TaDuc-TD/STM32KIT/Potentiometer_Bourns_3296W_Vertical.STEP

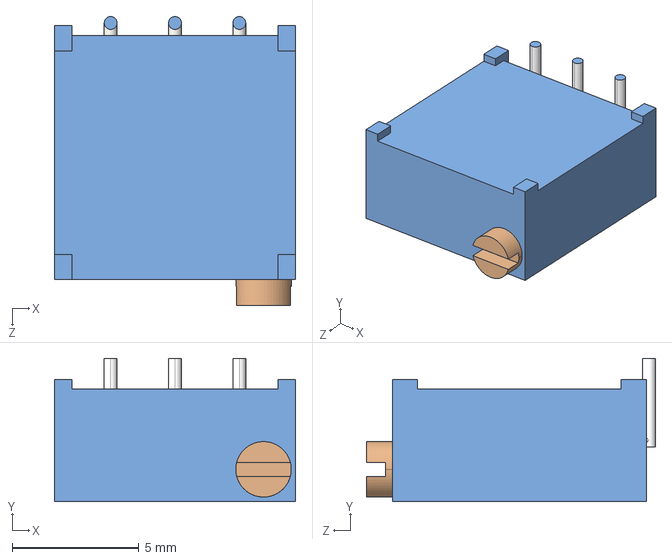
[picture p3: CAD file, 2026-10-21]
Potentiometer_Bourns_3296W_Vertical.STEP
9.53 x 5.67 x 11.4 mm
