TaDuc-TD/STM32KIT/LCD.STEP

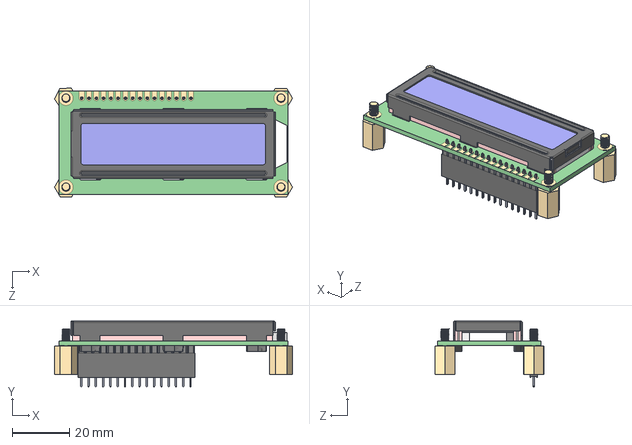
[picture p4: CAD file, 2026-10-21]
LCD.STEP
83.0 x 23.0 x 38.0 mm
LCD
M3 x10 x 6mm Male Female_ x 4
