TaDuc-TD/STM32KIT/RK0971-L-15RE_N-5-green.step

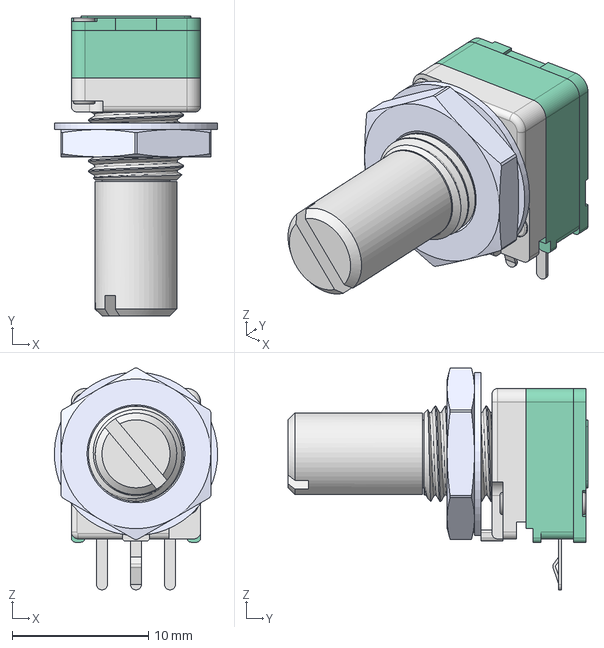
[picture p5: CAD file, 2026-10-21]
RK0971-L-15RE_N-5-green.step
12.0 x 22.1 x 16.3 mm
