TaDuc-TD/STM32KIT/switch small.stp

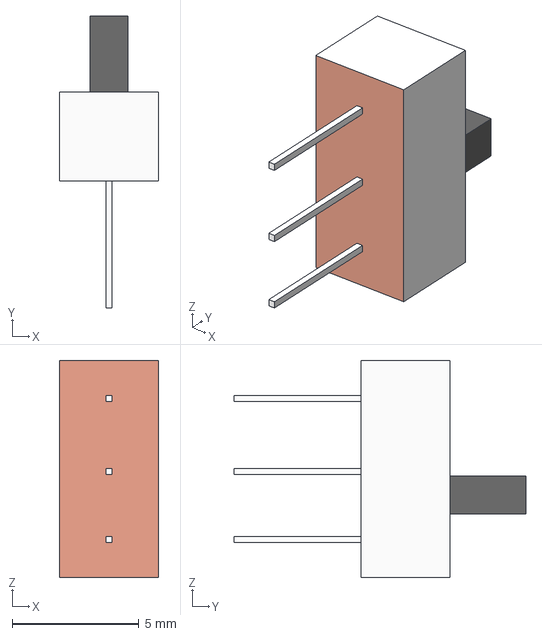
[picture p6: CAD file, 2026-10-21]
switch small.stp
3.90 x 11.5 x 8.55 mm
