TaDuc-TD/STM32KIT/KIT_STM32F401.kicad_pcb

## KiCad design KIT_STM32F401.kicad_pcb (2026-10-21)

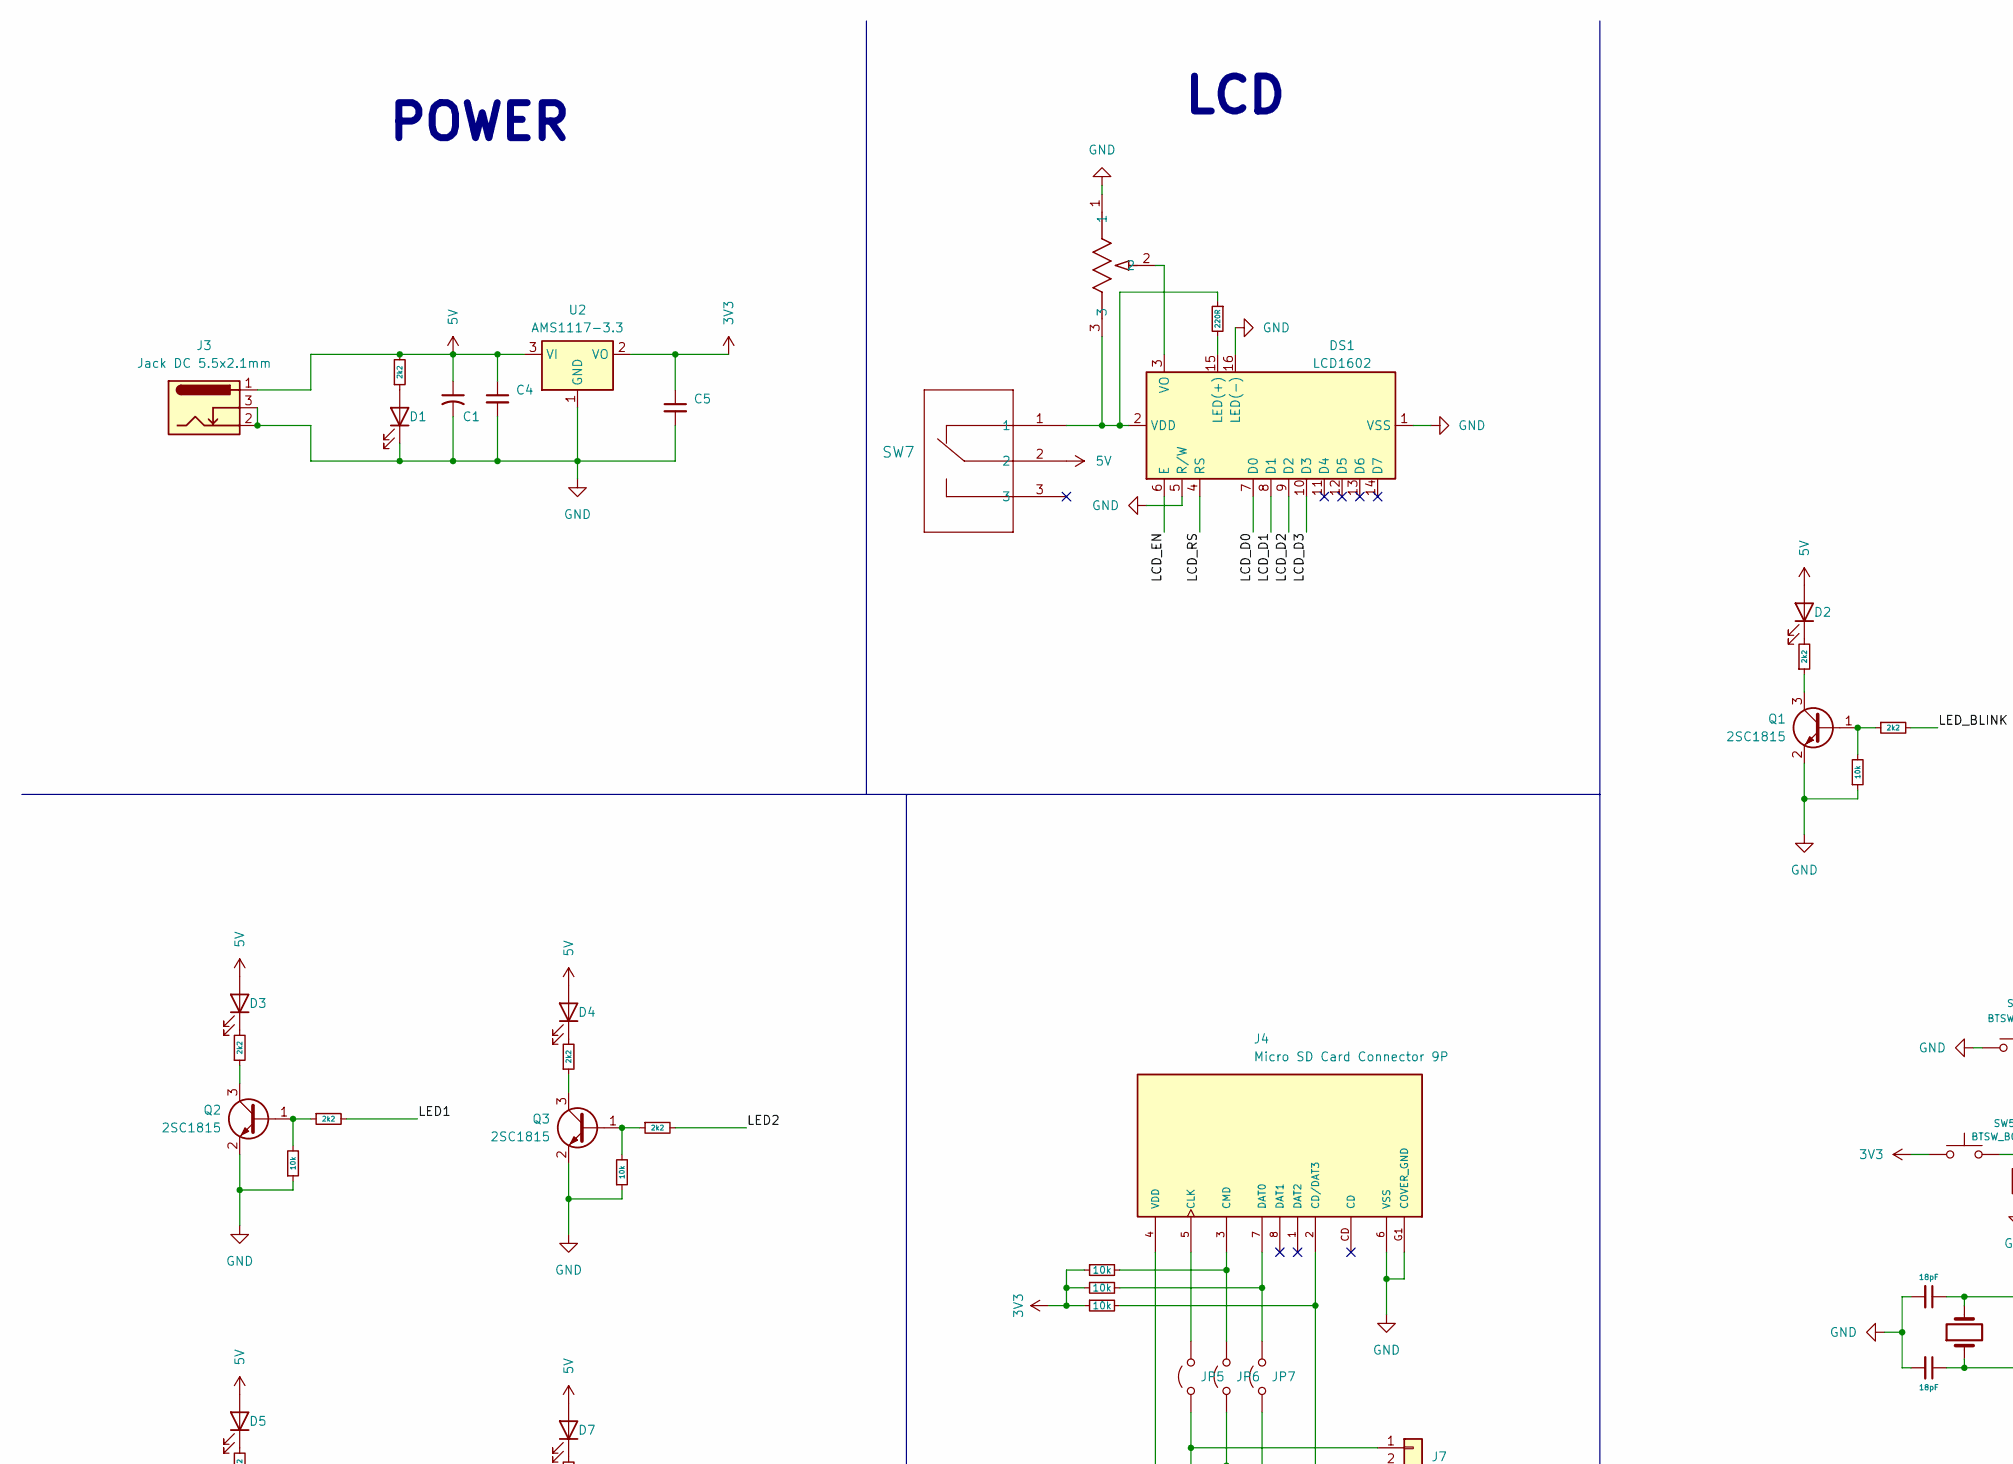
[picture p7: schematic KIT_STM32F401.kicad_sch, part in row 1, column 1]

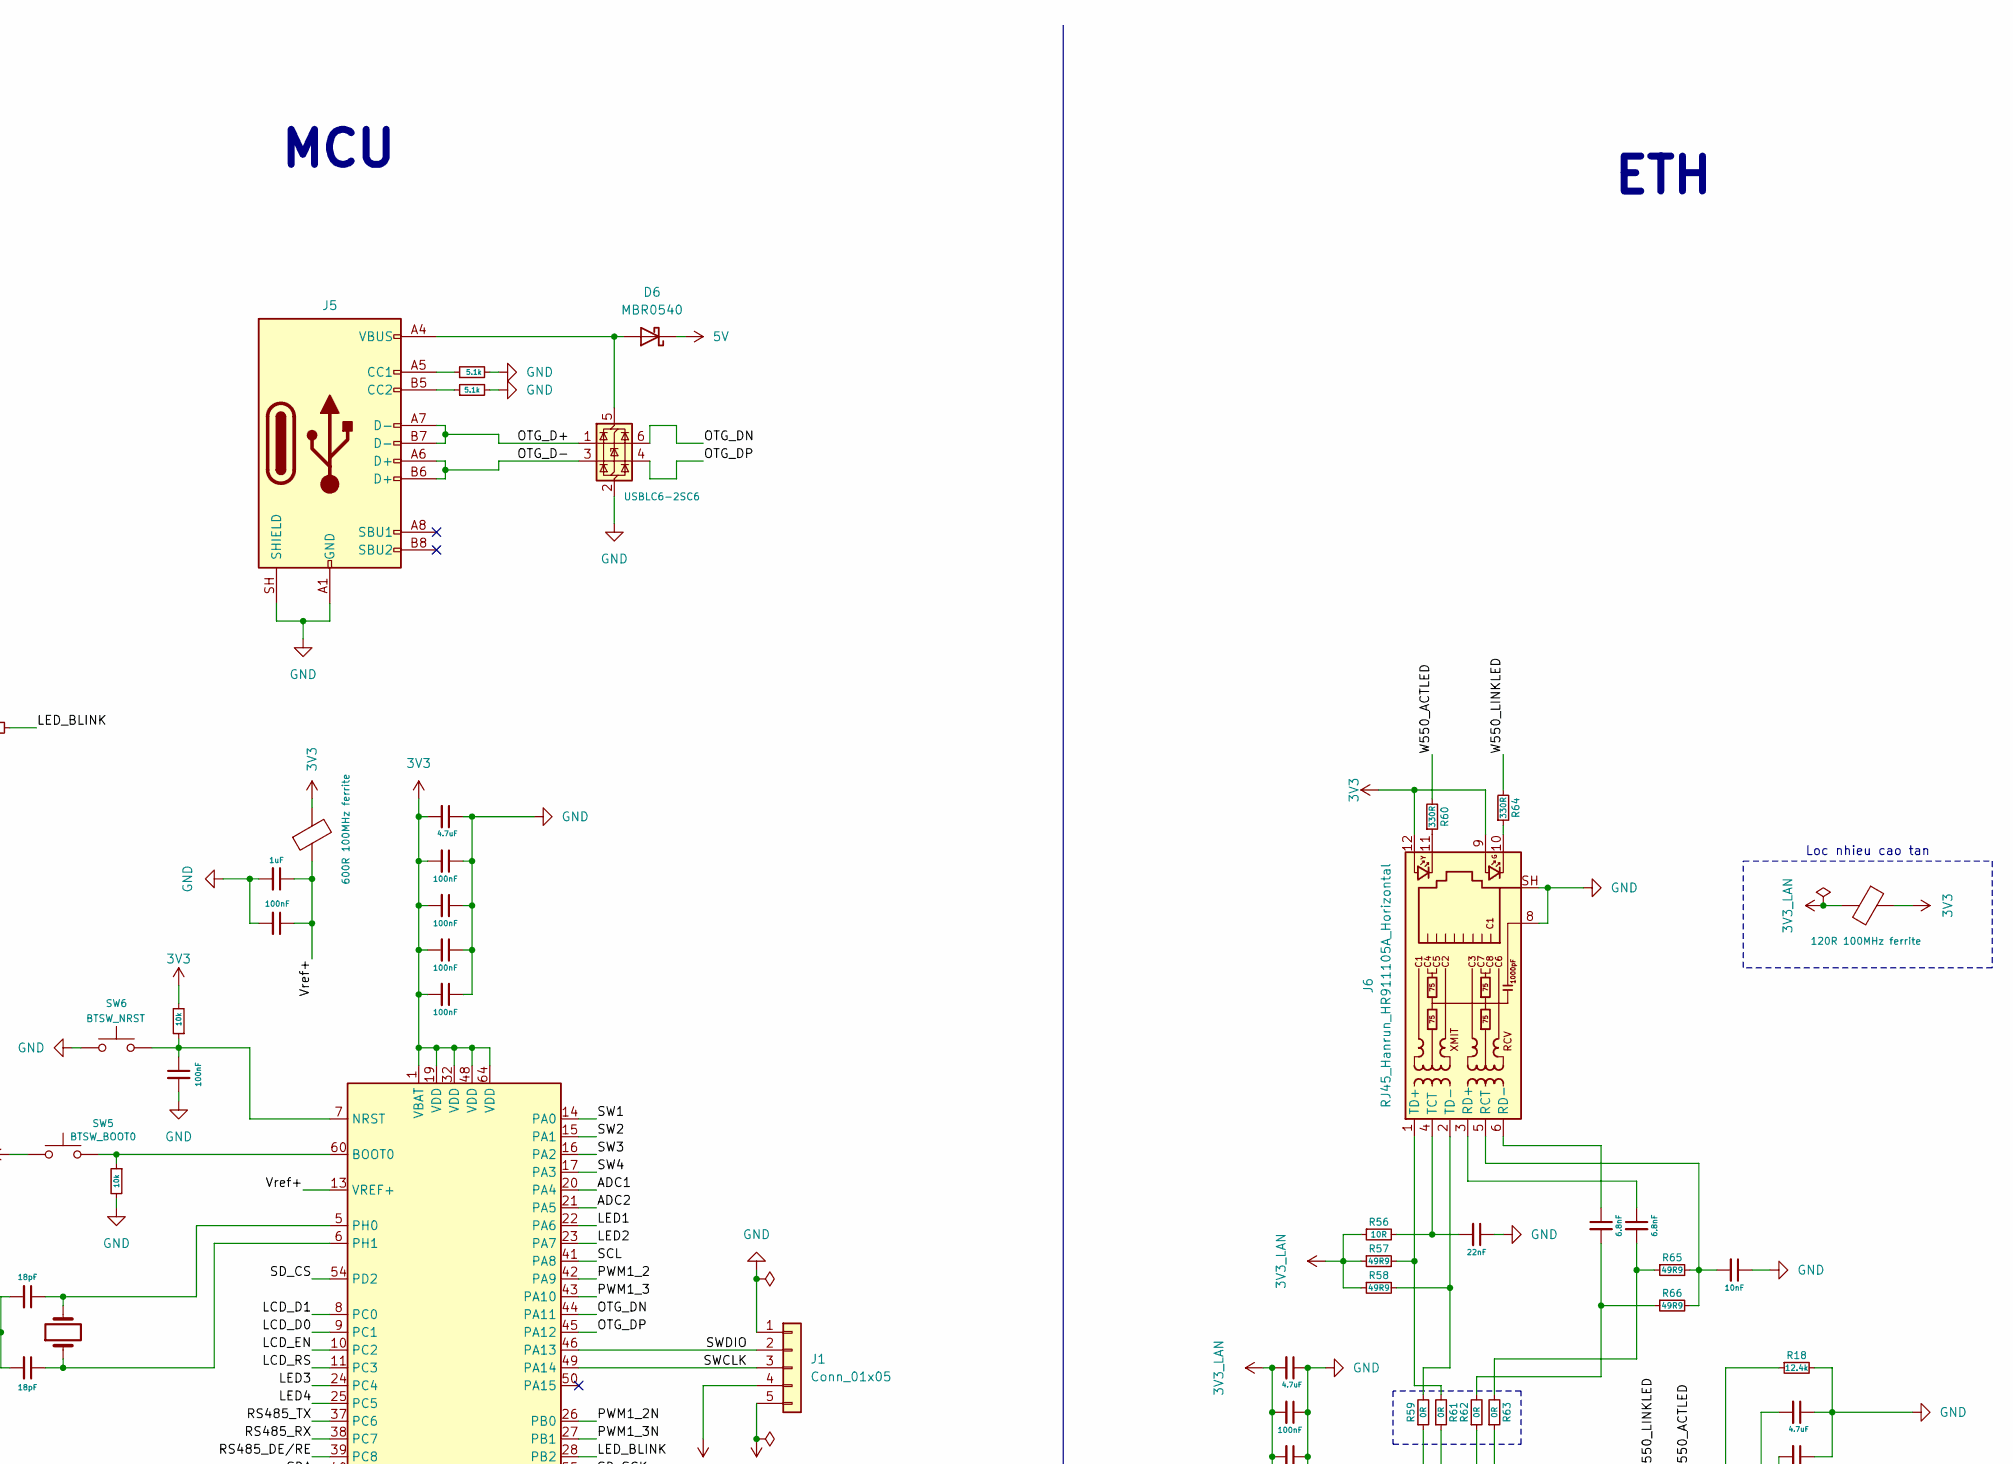
[picture p8: schematic KIT_STM32F401.kicad_sch, part in row 1, column 2]

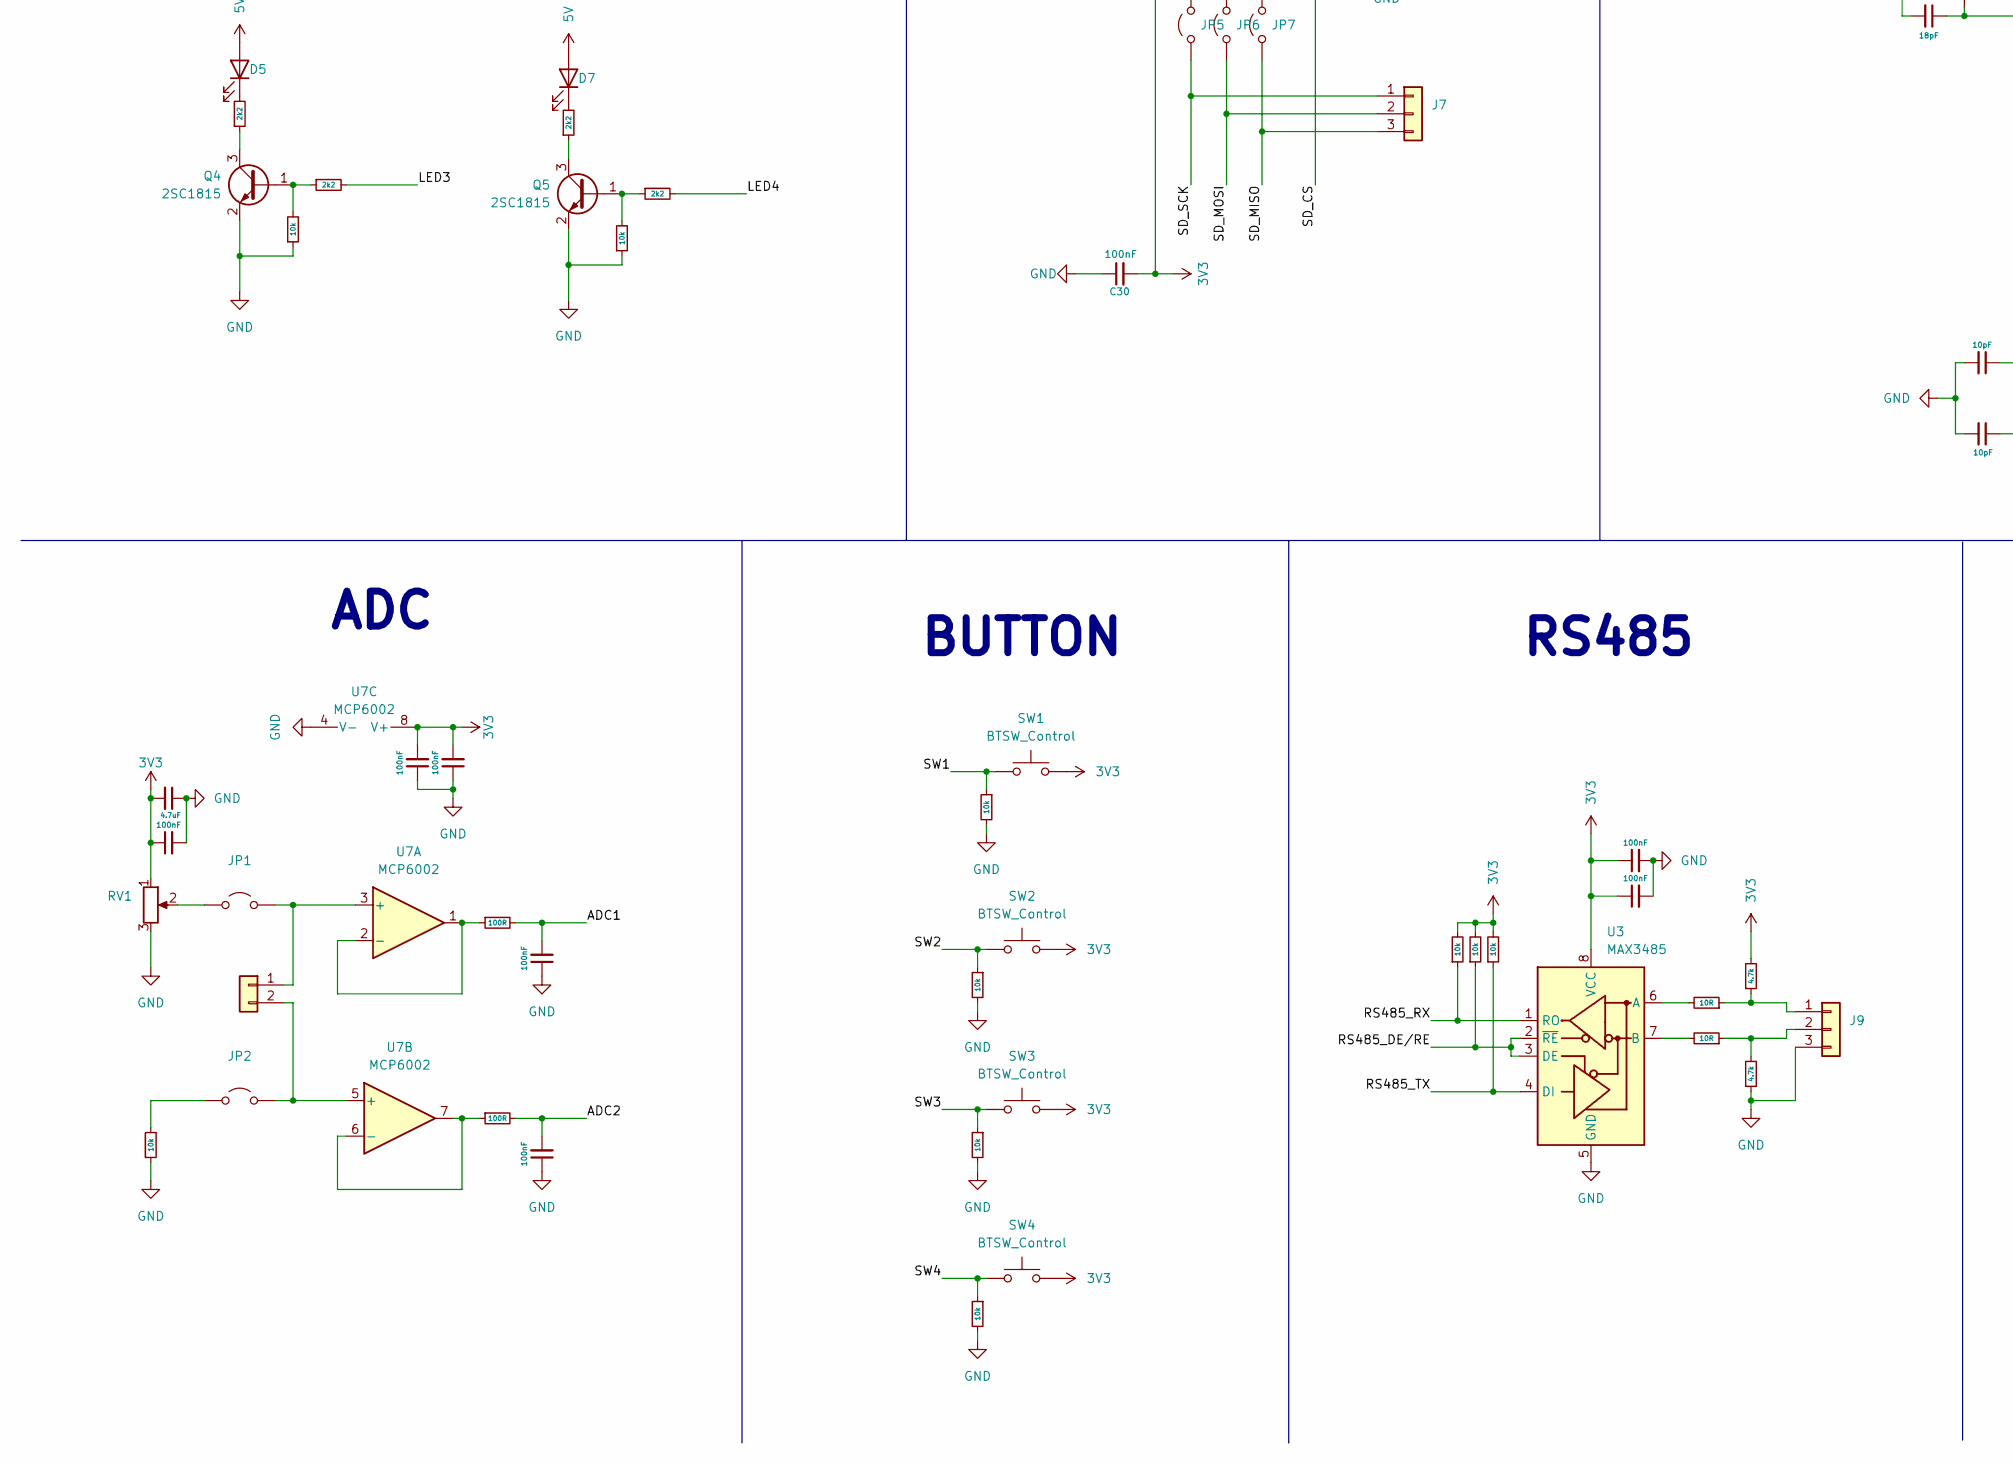
[picture p9: schematic KIT_STM32F401.kicad_sch, part in row 2, column 1]

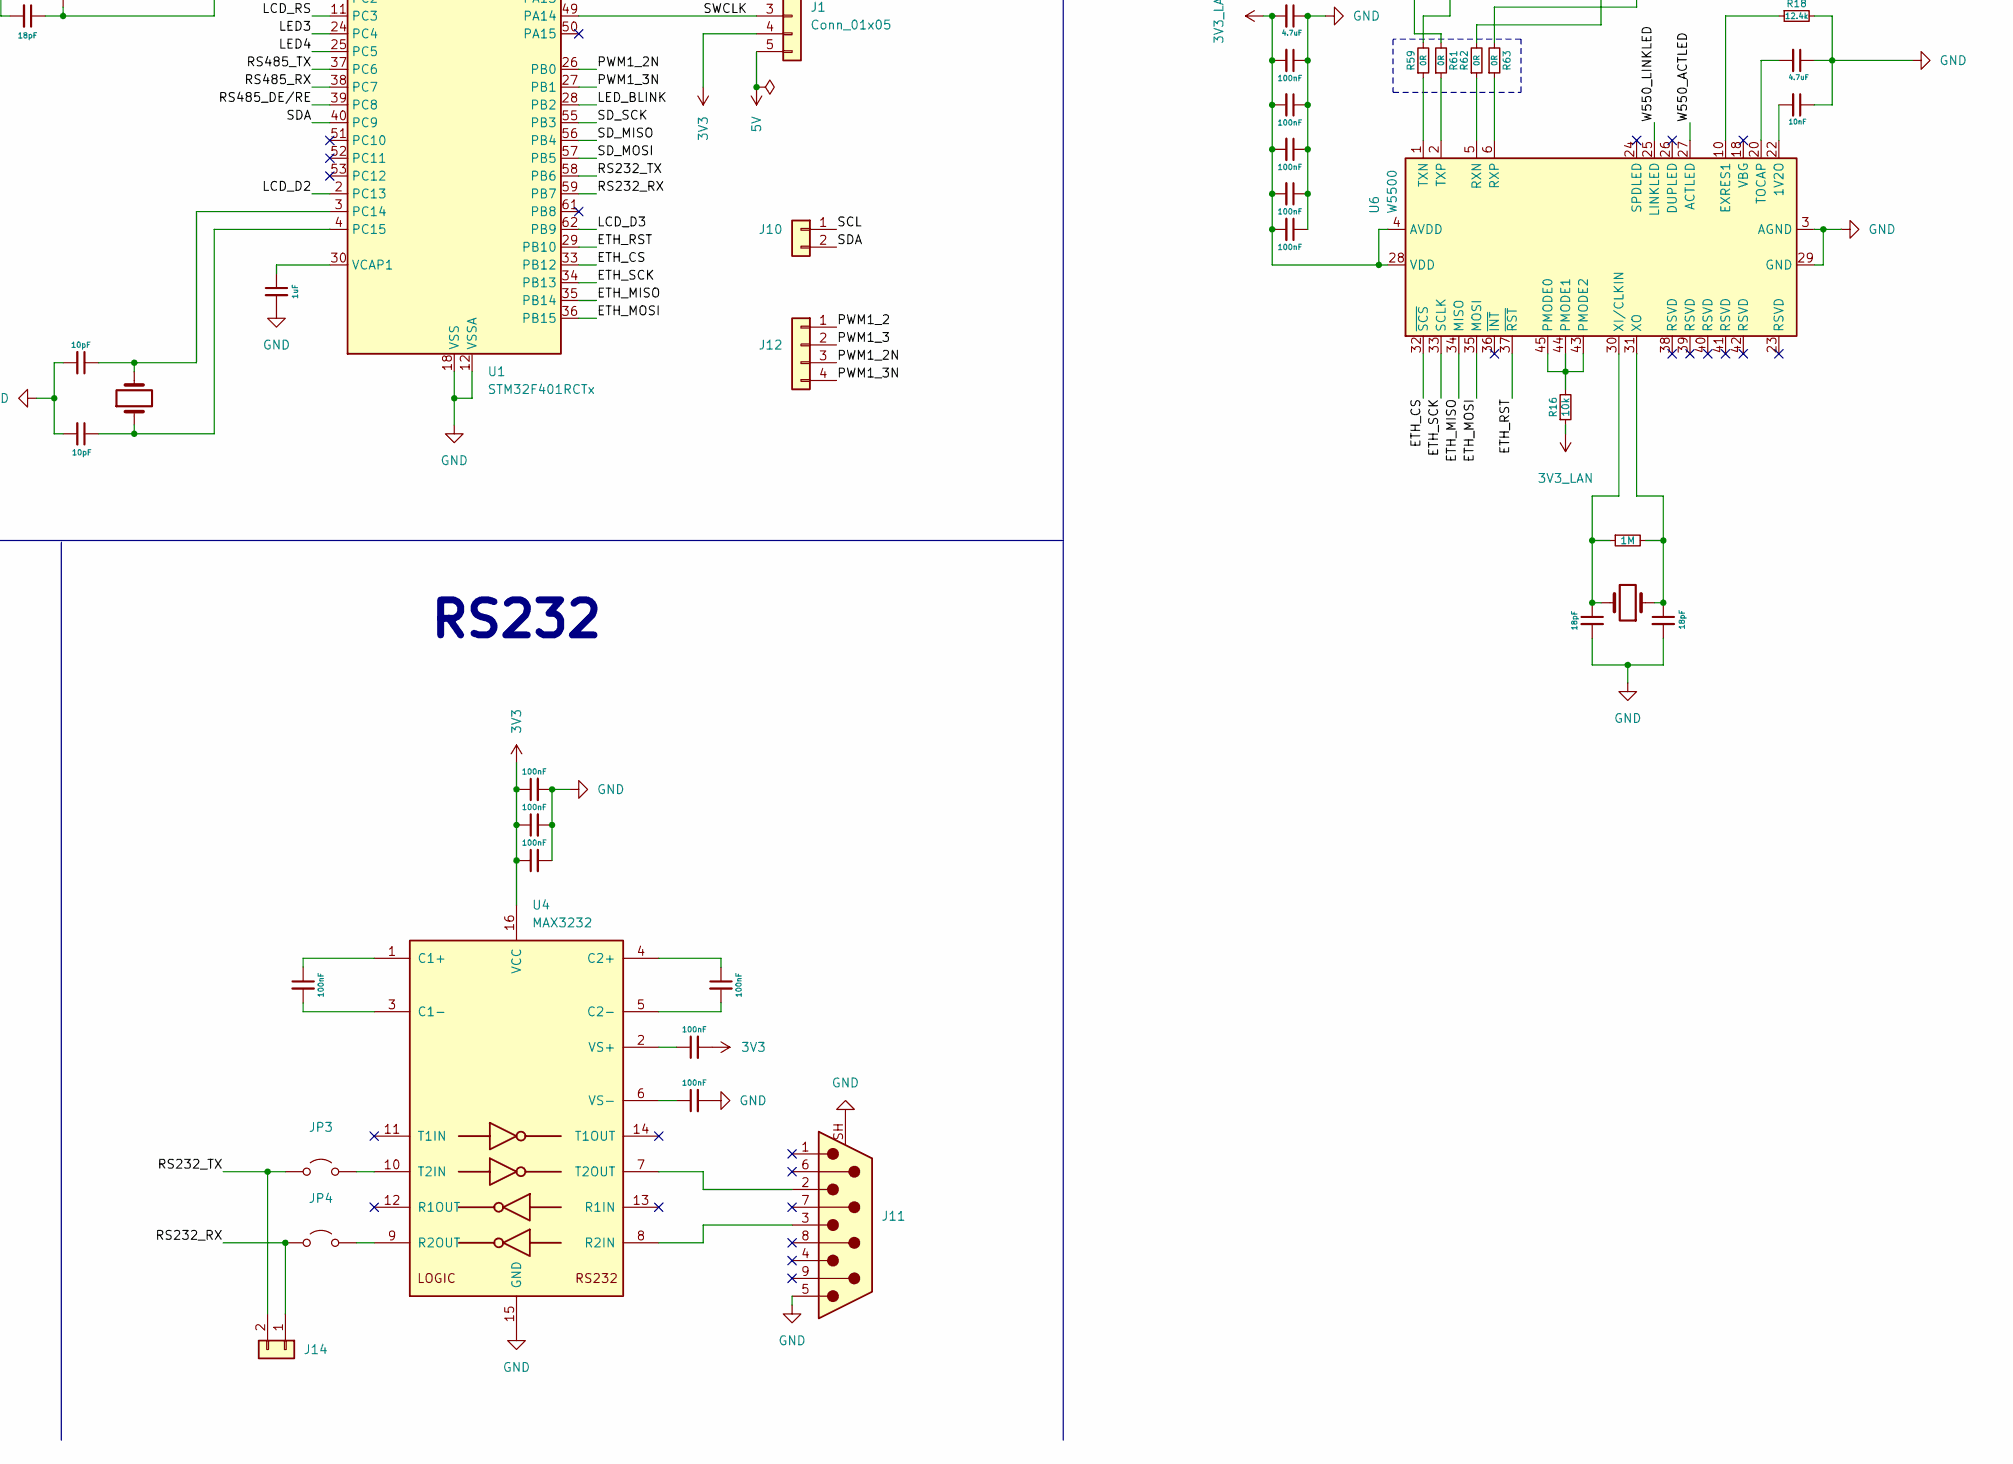
[picture p10: schematic KIT_STM32F401.kicad_sch, part in row 2, column 2]

Parts:
C1: 220uF; CP_Elec_10x10
C4, C30, C33, C35, C36, C37, C38, C39, C42, C43, C44, C45, C46, C47, C48, C49, C50, C51, C52, C53, C54, C56, C57, C58, C59, C69, C70: 100nF; C_0603_1608Metric
C5, C34, C55, C67, C71: 4.7uF; C_1206_3216Metric
C24, C25, C62, C65: 18pF; C_0603_1608Metric
C31, C32: 10pF; C_0603_1608Metric
C40, C41: 1uF; C_1206_3216Metric
C61: 22nF; C_0603_1608Metric
C63, C64: 6.8nF; C_0603_1608Metric
C66, C68: 10nF; C_0603_1608Metric
D1, D2, D3, D4, D5, D7: LED; LED_1206_3216Metric
D6: MBR0540; D_SOD-123
DS1: LCD1602; WC1602A
FB2: 600R 100MHz ferrite; L_0603_1608Metric
FB3: 120R 100MHz ferrite; L_0603_1608Metric
J1: Conn_01x05; PinHeader_1x05_P2.54mm_Vertical
J3: Jack DC 5.5x2.1mm; BarrelJack_GCT_DCJ200-10-A_Horizontal
J4: Micro SD Card Connector 9P; CUI_MSD-4-A; PARTREV 1.0
J5: USB_C_USB2.0_16P; USB_C_Receptacle_GCT_USB4105-xx-A_16P_TopMnt_Horizontal
J6: RJ45_Hanrun_HR911105A_Horizontal
J7: Conn_01x03; PinHeader_1x03_P2.54mm_Vertical
J8: Conn_01x02; PhoenixContact_MSTBA_2,5_2-G-5,08_1x02_P5.08mm_Horizontal
J9: Conn_01x03; PhoenixContact_MSTBA_2,5_3-G-5,08_1x03_P5.08mm_Horizontal
J10, J14: Conn_01x02; PinHeader_1x02_P2.54mm_Vertical
J11: DE9_Connecter_RS232; DSUB-9_Socket_Horizontal_P2.77x2.84mm_EdgePinOffset7.70mm_H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
J12: Conn_01x04; PinHeader_1x04_P2.54mm_Vertical
JP1, JP2, JP3, JP4, JP5, JP6, JP7: Jump 01x02; PinHeader_1x02_P2.54mm_Vertical
Q1, Q2, Q3, Q4, Q5: 2SC1815; TSOT-23
R1: Biến trở vuông 10k; POT_3362P
R10: 1M; R_0603_1608Metric
R16, R22, R23, R24, R25, R26, R29, R30, R31, R36, R39, R41, R42, R45, R48, R51, R54, R89, R90: 10k; R_0603_1608Metric
R18: 12.4k; R_0603_1608Metric
R20, R21: 5.1k; R_0603_1608Metric
R27: 220R; R_0603_1608Metric
R28, R37, R38, R44, R46, R47, R49, R50, R52, R53, R55: 2k2; R_0603_1608Metric
R32, R33: 4.7k; R_0603_1608Metric
R34, R35, R56: 10R; R_0603_1608Metric
R40, R43: 100R; R_0603_1608Metric
R57, R58, R65, R66: 49R9; R_0603_1608Metric
R59, R61, R62, R63: 0R; R_0603_1608Metric
R60, R64: 330R; R_0603_1608Metric
RV1: Biến trở 10k RK097; Potentiometer_Alps_RK097_Single_Horizontal
SW1, SW2, SW3, SW4: BTSW_Control; SW_Push_1P1T_NO_E-Switch_TL3301NxxxxxG
SW5: BTSW_BOOT0; SW_SPST_TS-1088-xR025
SW6: BTSW_NRST; SW_SPST_TS-1088-xR025
SW7: SW-SS12D00; 1P2T_SS-12D00_CNK
U1: STM32F401RCTx; LQFP-64_10x10mm_P0.5mm
U2: AMS1117-3.3; SOT-223-3_TabPin2
U3: MAX3485; SOIC-8_3.9x4.9mm_P1.27mm
U4: MAX3232; SOP-16_4.4x10.4mm_P1.27mm
U5: USBLC6-2SC6; SOT-23-6
U6: W5500; LQFP-48_7x7mm_P0.5mm
U7: MCP6002; SOIC-8_3.9x4.9mm_P1.27mm
Y3: 25MHz; Crystal_SMD_HC49-SD
Y4: 32.768k; Crystal_C38-LF_D3.0mm_L8.0mm_Vertical
Y5: 32.768k; Crystal_SMD_HC49-SD

Connections:
3V3: C5.1, C30.2, C34.2, C35.2, C36.2, C37.2, C38.2, C44.1, C45.1, C46.1, C47.2, C49.1, C50.1, C51.2, C52.2, C70.1, C71.2, FB2.2, FB3.1, J1.4, J4.4 (VDD), J6.9, J6.12, R23.2, R29.2, R30.2, R31.2, R32.2, R42.1, R89.1, R90.1, RV1.1, SW1.2, SW2.2, SW3.2, SW4.2, SW5.2, U1.1 (VBAT), U1.19 (VDD), U1.32 (VDD), U1.48 (VDD), U1.64 (VDD), U2.2 (VO), U3.8 (VCC), U4.16 (VCC), U7.8 (V+); also elsewhere on the board
3V3_LAN: C55.2, C56.2, C57.2, C58.2, C59.2, C69.2, FB3.2, R16.1, R56.1, R57.1, R58.1, U6.4 (AVDD), U6.8 (AVDD), U6.11 (AVDD), U6.15 (AVDD), U6.17 (AVDD), U6.21 (AVDD), U6.28 (VDD)
5V: C1.1, C4.1, D2.2 (A), D3.2 (A), D4.2 (A), D5.2 (A), D6.1 (K), D7.2 (A), J1.5, J3.1, R28.2, SW7.2, U2.3 (VI)
/ADC1: C53.2, R40.2, U1.20 (PA4)
/ADC2: C54.2, R43.2, U1.21 (PA5)
/ETH_CS: U1.33 (PB12), U6.32 (~SCS)
/ETH_MISO: U1.35 (PB14), U6.34 (MISO)
/ETH_MOSI: U1.36 (PB15), U6.35 (MOSI)
/ETH_RST: U1.29 (PB10), U6.37 (~RST)
/ETH_SCK: U1.34 (PB13), U6.33 (SCLK)
/LCD_D0: DS1.7 (D0), U1.9 (PC1)
/LCD_D1: DS1.8 (D1), U1.8 (PC0)
/LCD_D2: DS1.9 (D2), U1.2 (PC13)
/LCD_D3: DS1.10 (D3), U1.62 (PB9)
/LCD_EN: DS1.6 (E), U1.10 (PC2)
/LCD_RS: DS1.4 (RS), U1.11 (PC3)
/LED1: R46.2, U1.22 (PA6)
/LED2: R49.2, U1.23 (PA7)
/LED3: R52.2, U1.24 (PC4)
/LED4: R55.2, U1.25 (PC5)
/LED_BLINK: R37.2, U1.28 (PB2)
/OTG_D+: J5.A7 (D-), J5.B7 (D-), U5.1 (I/O1)
/OTG_D-: J5.A6 (D+), J5.B6 (D+), U5.3 (I/O2)
/OTG_DN: U1.44 (PA11), U5.6 (I/O1)
/OTG_DP: U1.45 (PA12), U5.4 (I/O2)
/PWM1_2: J12.1, U1.42 (PA9)
/PWM1_2N: J12.3, U1.26 (PB0)
/PWM1_3: J12.2, U1.43 (PA10)
/PWM1_3N: J12.4, U1.27 (PB1)
/RS232_RX: J14.1, JP4.1 (A), U1.59 (PB7)
/RS232_TX: J14.2, JP3.1 (A), U1.58 (PB6)
/RS485_DE/RE: R30.1, U1.39 (PC8), U3.2 (~RE), U3.3 (DE)
/RS485_RX: R31.1, U1.38 (PC7), U3.1 (RO)
/RS485_TX: R29.1, U1.37 (PC6), U3.4 (DI)
/SCL: J10.1, U1.41 (PA8)
/SDA: J10.2, U1.40 (PC9)
/SD_CS: J4.2 (CD/DAT3), R90.2, U1.54 (PD2)
/SD_MISO: J7.3, JP7.1 (A), U1.56 (PB4)
/SD_MOSI: J7.2, JP6.1 (A), U1.57 (PB5)
/SD_SCK: J7.1, JP5.1 (A), U1.55 (PB3)
/SW1: R24.1, SW1.1, U1.14 (PA0)
/SW2: R25.1, SW2.1, U1.15 (PA1)
/SW3: R26.1, SW3.1, U1.16 (PA2)
/SW4: R36.1, SW4.1, U1.17 (PA3)
/SWCLK: J1.3, U1.49 (PA14)
/SWDIO: J1.2, U1.46 (PA13)
/Vref+: C39.1, C40.1, FB2.1, U1.13 (VREF+)
/W550_ACTLED: R60.2, U6.27 (ACTLED)
/W550_LINKLED: R64.2, U6.25 (LINKLED)
GND: C1.2, C4.2, C5.2, C24.2, C25.2, C30.1, C31.2, C32.2, C33.2, C34.1, C35.1, C36.1, C37.1, C38.1, C39.2, C40.2, C41.2, C44.2, C45.2, C46.2, C48.2, C49.2, C50.2, C51.1, C52.1, C53.1, C54.1, C55.1, C56.1, C57.1, C58.1, C59.1, C61.1, C62.2, C65.2, C66.1, C67.1, C68.1, C69.1, C70.2, C71.1, D1.1 (K), DS1.1 (VSS), DS1.5 (R/W), DS1.16 (LED(-)), J1.1, J3.2, J3.3, J4.6 (VSS), J4.G1 (COVER_GND), J4.G2 (COVER_GND), J4.G3 (COVER_GND), J4.G4 (COVER_GND), J5.A1 (GND), J5.A12 (GND), J5.B1 (GND), J5.B12 (GND), J5.SH (SHIELD), J6.8, J6.SH, J9.3, J11.5, J11.SH (PAD), Q1.2 (E), Q2.2 (E), Q3.2 (E), Q4.2 (E), Q5.2 (E), R1.1, R18.2, R20.2, R21.2, R22.2, R24.2, R25.2, R26.2, R33.1, R36.2, R39.1, R41.1, R45.1, R48.1, R51.1, R54.1, RV1.3, SW6.1, U1.12 (VSSA), U1.18 (VSS), U1.31 (VSS), U1.47 (VSS), U1.63 (VSS), U2.1 (GND), U3.5 (GND), U4.15 (GND), U5.2 (GND), U6.3 (AGND), U6.9 (AGND), U6.14 (AGND), U6.16 (AGND), U6.19 (AGND), U6.29 (GND), U6.48 (AGND), U7.4 (V-); also elsewhere on the board
unnamed: C63.2, R62.2, R66.1
unnamed: C64.2, R63.2, R65.1
unnamed: D1.2 (A), R28.1
unnamed: D2.1 (K), R38.2
unnamed: D3.1 (K), R44.2
unnamed: D4.1 (K), R47.2
unnamed: D5.1 (K), R50.2
unnamed: D6.2 (A), J5.A4 (VBUS), J5.A9 (VBUS), J5.B4 (VBUS), J5.B9 (VBUS), U5.5 (VBUS)
unnamed: D7.1 (K), R53.2
unnamed: DS1.15 (LED(+)), R27.2
unnamed: DS1.2 (VDD), R1.3, R27.1, SW7.1
unnamed: DS1.3 (VO), R1.2
unnamed: J4.5 (CLK), JP5.2 (B)
unnamed: J4.3 (CMD), JP6.2 (B), R42.2
unnamed: J4.7 (DAT0), JP7.2 (B), R89.2
unnamed: J5.A5 (CC1), R20.1
unnamed: J5.B5 (CC2), R21.1
unnamed: J6.10, R64.1
unnamed: J6.11, R60.1
unnamed: C66.2, J6.5 (RCT), R65.2, R66.2
unnamed: C64.1, J6.3 (RD+)
unnamed: C63.1, J6.6 (RD-)
unnamed: C61.2, J6.4 (TCT), R56.2
unnamed: J6.1 (TD+), R57.2, R61.2
unnamed: J6.2 (TD-), R58.2, R59.2
unnamed: J8.1, JP1.2 (B), U7.3 (+)
unnamed: J8.2, JP2.2 (B), U7.5 (+)
unnamed: J9.1, R32.1, R34.1
unnamed: J9.2, R33.2, R35.1
unnamed: JP1.1 (A), RV1.2
unnamed: JP2.1 (A), R41.2
unnamed: JP3.2 (B), U4.10 (T2IN)
unnamed: JP4.2 (B), U4.9 (R2OUT)
unnamed: Q1.1 (B), R37.1, R39.2
unnamed: Q1.3 (C), R38.1
unnamed: Q2.1 (B), R45.2, R46.1
unnamed: Q2.3 (C), R44.1
unnamed: Q3.1 (B), R48.2, R49.1
unnamed: Q3.3 (C), R47.1
unnamed: Q4.1 (B), R51.2, R52.1
unnamed: Q4.3 (C), R50.1
unnamed: Q5.1 (B), R54.2, R55.1
unnamed: Q5.3 (C), R53.1
unnamed: R22.1, SW5.1, U1.60 (BOOT0)
unnamed: C33.1, R23.1, SW6.2, U1.7 (NRST)
unnamed: C31.1, U1.3 (PC14), Y4.2
unnamed: C32.1, U1.4 (PC15), Y4.1
unnamed: C24.1, U1.5 (PH0), Y5.2
unnamed: C25.1, U1.6 (PH1), Y5.1
unnamed: C41.1, U1.30 (VCAP1)
unnamed: R34.2, U3.6 (A)
unnamed: R35.2, U3.7 (B)
unnamed: C42.1, U4.1 (C1+)
unnamed: C42.2, U4.3 (C1-)
unnamed: C43.1, U4.4 (C2+)
unnamed: C43.2, U4.5 (C2-)
unnamed: J11.3, U4.8 (R2IN)
unnamed: J11.2, U4.7 (T2OUT)
unnamed: C47.1, U4.2 (VS+)
unnamed: C48.1, U4.6 (VS-)
unnamed: C68.2, U6.22 (1V2O)
unnamed: R18.1, U6.10 (EXRES1)
unnamed: R16.2, U6.43 (PMODE2), U6.44 (PMODE1), U6.45 (PMODE0)
unnamed: R62.1, U6.5 (RXN)
unnamed: R63.1, U6.6 (RXP)
unnamed: C67.2, U6.20 (TOCAP)
unnamed: R59.1, U6.1 (TXN)
unnamed: R61.1, U6.2 (TXP)
unnamed: C62.1, R10.1, U6.30 (XI/CLKIN), Y3.2
unnamed: C65.1, R10.2, U6.31 (XO), Y3.1
unnamed: R40.1, U7.1, U7.2 (-)
unnamed: R43.1, U7.6 (-), U7.7

Notes on the sheet:
ETH
RS485
LCD
Loc nhieu cao tan
BUTTON
MCU
ADC
POWER
RS232

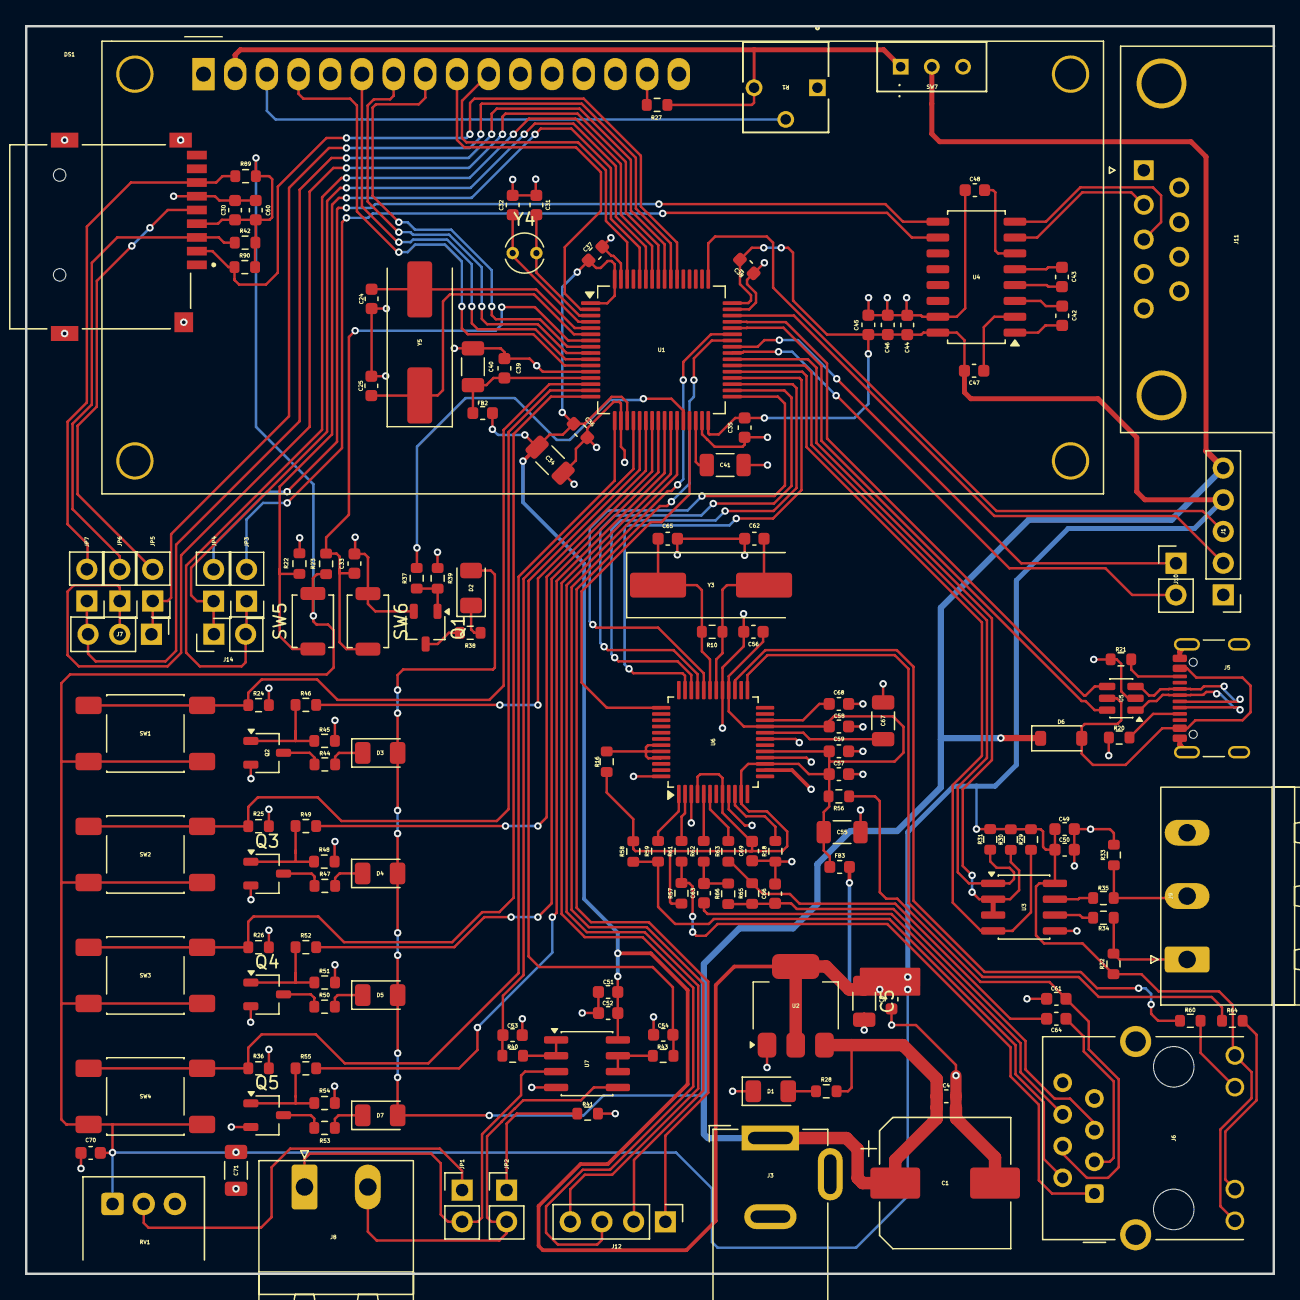
[picture p11: board KIT_STM32F401.kicad_pcb from above]

Board: 2 copper layers, 100.0 x 100.0 mm, 153 parts (0 on the bottom side), 122 nets.

Other parts of the board:
C5#2: C_Small; C_0603_1608Metric
C60: 10uF; C_0603_1608Metric

Their connections:
3V3: C5#2.1, C60.2; also elsewhere on the board
GND: C5#2.2, C60.1; also elsewhere on the board
