TaDuc-TD/STM32KIT/(commit log)

2026-10-21 Initial commit: STM32F401 PCB design
    [KIT_STM32F401.kicad_pcb, KIT_STM32F401.kicad_sch, LCD.STEP, Potentiometer_Bourns_3296W_Vertical.STEP, RK0971-L-15RE_N-5-green.step, switch small.stp]
2026-10-21 Add PCB images to README
